tapeout-unsw/tapeout/docs/diagrams/bus/bus-timing-simple.png

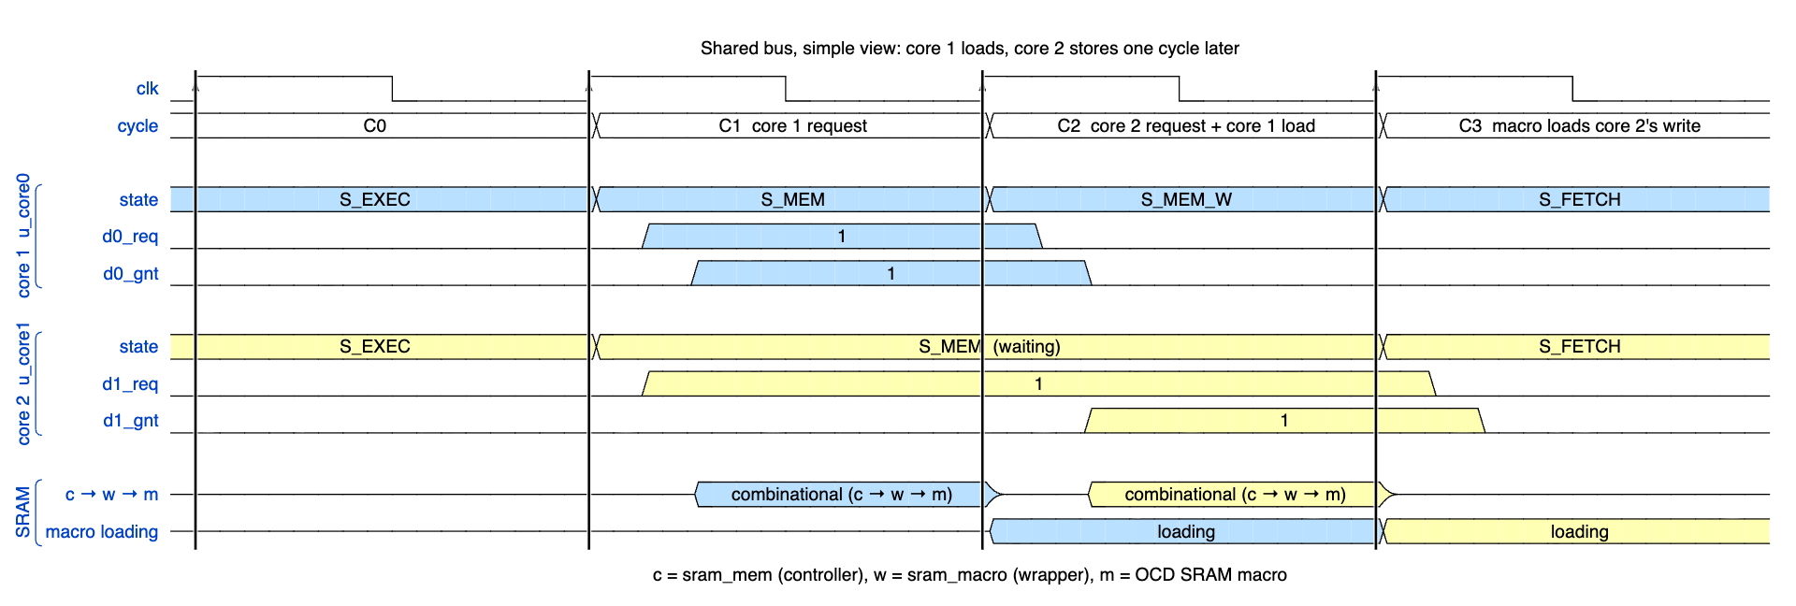
docs/diagrams/bus/bus-timing-simple.png
