tapeout-unsw/tapeout/docs/diagrams/top-level/soc-top-block-diagram.png

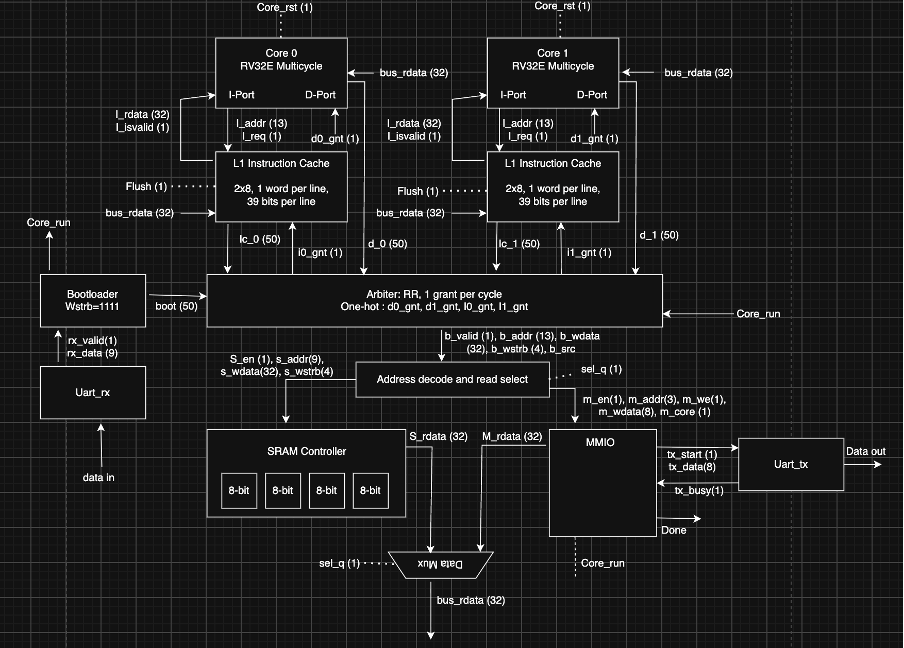
docs/diagrams/top-level/soc-top-block-diagram.png
