tapeout-unsw/tapeout/(commit log)

2026-10-06 Storage Implementation (Proofreading currently)
2026-10-08 Full case for b_src
2026-10-08 Arbiter draft There are some latches and errors I need to fix
    [arbiter.sv]
2026-10-08 Fix latches? Need to compile later
    [arbiter.sv]
2026-10-08 Fix pointer updates and source selection
    [arbiter.sv]
2026-10-09 cache: cocotb tests for icache
    Block-level tests for rtl/cache/icache.sv, written against the behaviour in
    its header: a Python reference model predicts every hit and miss, and each
    fetch is checked for data, timing and bus behaviour. Directed tests cover
    fill, both ways, LRU, flush (including flush beating a fill), reset and a
    bootloader reload; a seeded random fetch stream and trace replay cover the
    rest. Runs at RAW=10 and 11. Tags are RAW-5 bits, as in the spec (39-bit
    lines, 2 KiB RAM); TAG_BITS=<n> tests a narrower tag.
    Also adds the shared cocotb setup from the setup guide: sim/requirements.txt,
    sim/cocotb/common/, `make test-cocotb` and `make test-cocotb-gated`, and a CI
    step. Like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
2026-10-10 ip: vendor OCD 3.3V SRAM gf180mcu_ocd added
2026-10-10 feat: sram_macro behavioural model and OCD 3.3V instances
2026-10-10 fix: run macro models and Icarus and sample rdata mid-cycle
2026-10-10 Cache LRU Policy MIA Currently
2026-10-13 feat: add assembly build pipeline and basic dual-core test
2026-10-17 verification: bus-to-core tests B1-B7
    B1 all load/store widths from one core, B2 both cores at once, B3 both cores
    under heavy I-cache traffic, B4 cores held off while loading, B5 real mmio
    (CORE_ID, LOCK-protected shared counter, UART, EXIT/done), B6 real
    bootloader, B7 whole soc_top end to end over UART.
    A per-cycle bus monitor checks every grant, forwarded request, addr_decode
    route and bus_rdata against a reference model of RAM and MMIO.
    addr_decode is still a stub, so these fail until it's implemented. With a
    version written from its header comment all pass on Verilator and Icarus.
    Run: pytest -s sim/cocotb/core_bus
2026-10-17 feat: add more standalone assembly programs and shared simulator
2026-10-18 test: add dual-core soc_top testbench
    soc_top_tb boots a program over serial and runs it on both cores, checking
    every fetch against the image, every RAM read against a shadow copy, and
    the arbiter grants. make test-soc-top runs the riscv-tests plus the
    multicore tests in tests/multicore (lock contention, shared byte lanes,
    I-cache aliasing, UART from both cores, memory walk, reload without reset).
    Claude-Session: https://claude.ai/code/session_018uiXBzhAD5GpNRkcn9TgLR
2026-10-18 feat: update SoC runner with UART and register checks
2026-10-30 atomics: fix compile and control bugs in the amoswap change
    Compile:
    - soc_top.sv: missing semicolon after c1_d_atomic; trailing comma in the
    arbiter port list
    - core.sv: trailing comma in the decoder port list; amo_* signals declared
    after their first use (iverilog rejects that); amp_wstrb typo; stray ;;
    Behaviour:
    - core.sv: S_EXEC sent amoswap down the load path (the decoder marks it
    mem_read), so the core never reached S_AMO_WAIT and u_amoswap stuck busy.
    An AMO now goes to S_AMO_WAIT
    - core.sv: the writeback mux started a second if chain after the AMO case,
    so the load branch overwrote amo_old; now one chain
    New port wiring:
    - check_top.sh compiles rtl/core/amoswap.sv
    - the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
2026-11-01 feat: add resident UART shell on core 0
2026-11-01 feat: refine resident UART rtl changes
